Churrosoft/OpenEFI-PCB_next/mainboard_uEFI/mainboard_uEFI.kicad_pcb

## KiCad design mainboard_uEFI/mainboard_uEFI.kicad_pcb (2023-02-02)

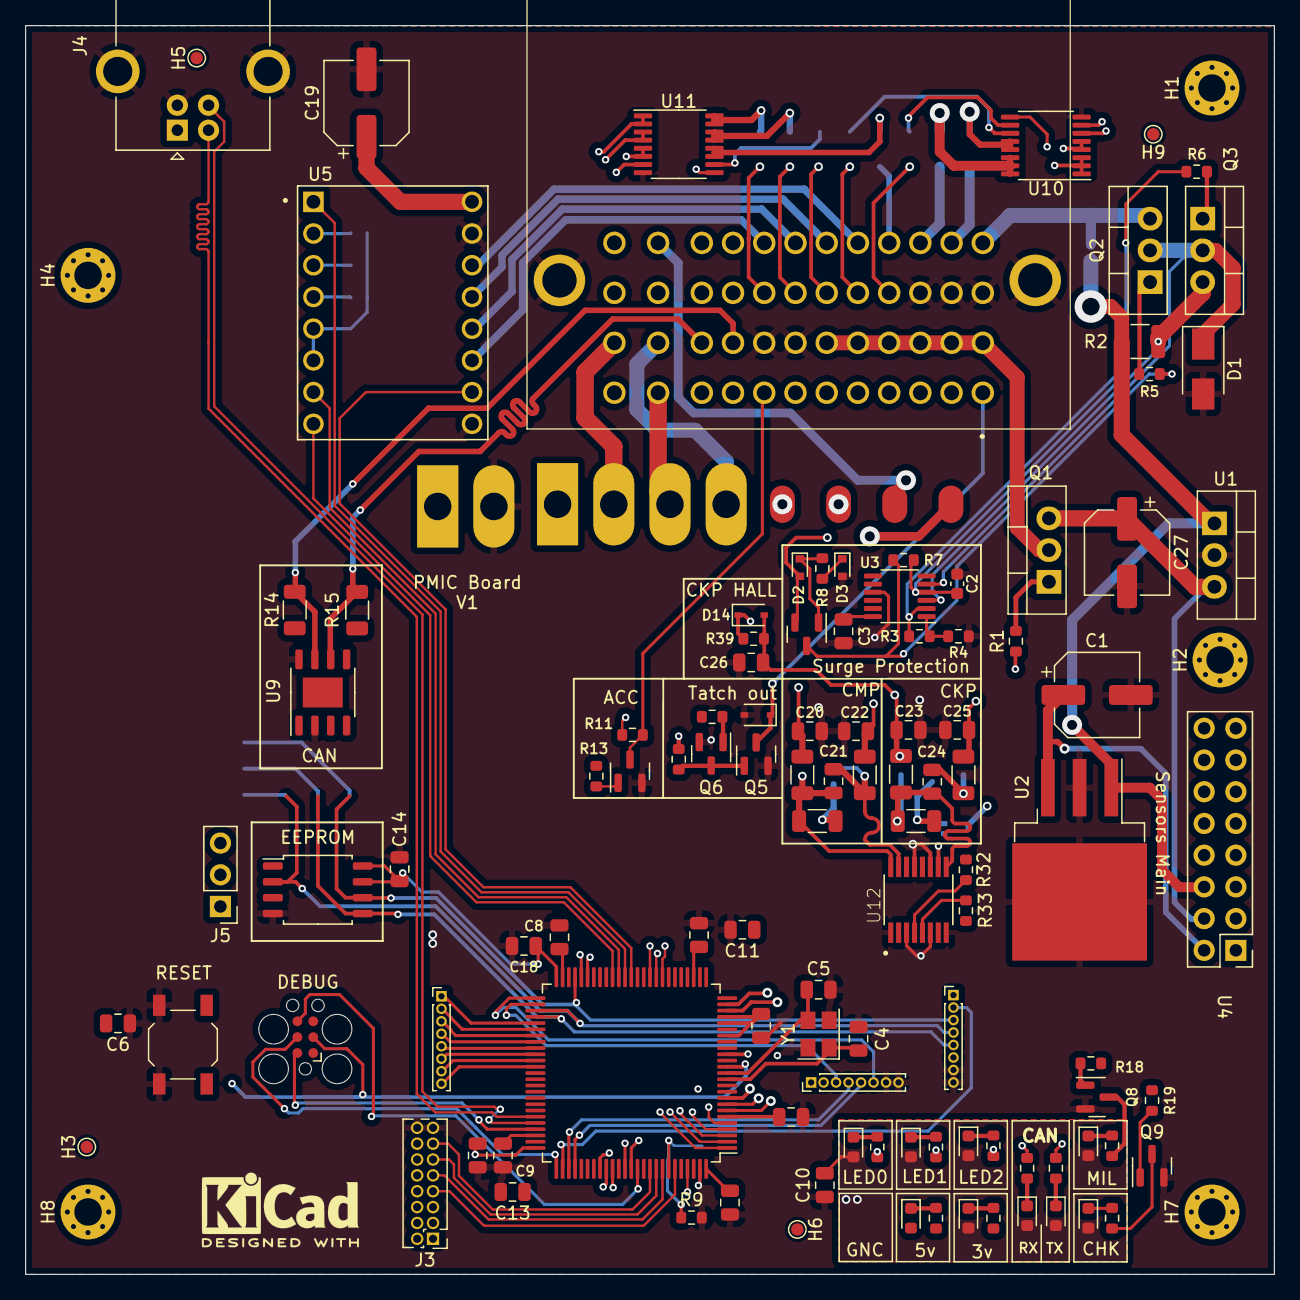
[picture p1: board mainboard_uEFI.kicad_pcb from above]

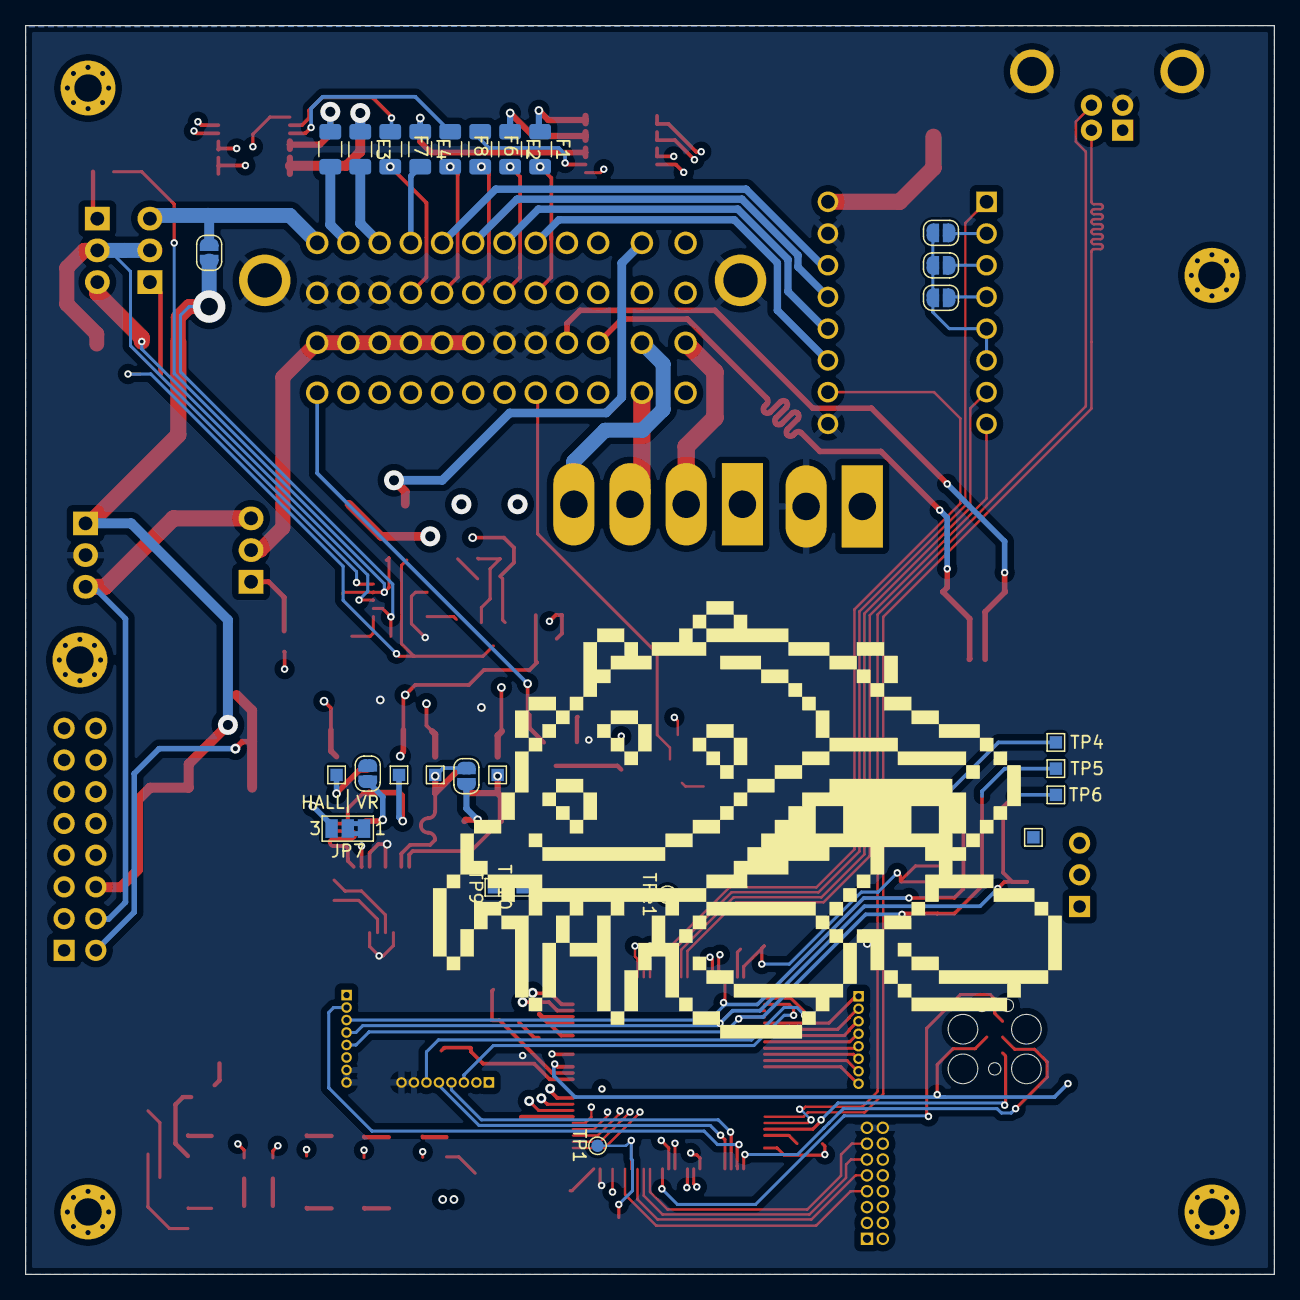
[picture p2: board mainboard_uEFI.kicad_pcb from below]

Board: 4 copper layers, 100.0 x 100.0 mm, 141 parts (27 on the bottom side), 143 nets.

Parts:
C1, C19, C27: 100uF ±20% 35V; CP_Elec_6.3x7.7
C2: 47nF; C_0603_1608Metric
C3, C6, C7, C10, C12, C13, C14, C15, C16, C17: 100nF; C_0805_2012Metric
C4, C5: 15pF; C_0805_2012Metric
C8, C9: 2.2uF; C_0805_2012Metric
C11: 1uF; C_0805_2012Metric
C18: 4.7uF; C_0805_2012Metric
C20, C21, C22, C23, C24, C25, C26: 0.01uF; C_0805_2012Metric
D1: SMAJ58CA; D_SMA
D2, D3: 1N4148; D_SOD-523
D4: MM3Z24VT1G; D_SOD-323
D5, D6, D7, D8, D9, D10, D11, D12, D13: LED; LED_0603_1608Metric
D14: K26; D_SOD-323
F1, F2, F3, F4, F5, F6, F7, F8: 750mA; Fuse_1206_3216Metric
H1, H2, H4, H7, H8: MountingHole; MountingHole_2.2mm_M2_Pad_Via
H3, H5, H6, H9: MountingHole; TestPoint_Pad_D1.0mm
J1: 36638-0002; 366380002
J2: Tag connect; Tag-Connect_TC2030-IDC-FP_2x03_P1.27mm_Vertical
J3: Conn_02x08_Odd_Even; PinHeader_2x08_P1.27mm_Vertical
J4: USB_B; USB_B_OST_USB-B1HSxx_Horizontal
J5: Conn_01x03; PinHeader_1x03_P2.54mm_Vertical
JP1: Jumper_NO_Small; SolderJumper-2_P1.3mm_Open_RoundedPad1.0x1.5mm
JP2, JP3, JP4, JP5, JP6: SolderJumper_2_Open; SolderJumper-2_P1.3mm_Open_RoundedPad1.0x1.5mm
JP7: vr/hall; SolderJumper-3_P1.3mm_Bridged2Bar12_Pad1.0x1.5mm_NumberLabe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
Q1: IRF540N; TO-220-3_Vertical
Q2, Q3: IRLZ44N; TO-220-3_Vertical
Q4, Q6, Q8, Q9: SS8050; SOT-23
Q5, Q7: AO3400A; SOT-23
R1, R5, R6: 10R 1/10W; R_0603_1608Metric
R2: 0.01R; R_1210_3225Metric
R3: 57.6K 1/10W; R_0603_1608Metric
R4: 4.99K 1/10W; R_0603_1608Metric
R7: 1M 1/10W; R_0603_1608Metric
R8: 10K 1/10W; R_0603_1608Metric
R9, R11, R13, R32, R33, R39: 10k; R_0603_1608Metric
R10: 100k; R_0603_1608Metric
R12, R18, R19: 1k; R_0603_1608Metric
R14, R15: 120R; R_1206_3216Metric
R16, R17, R20, R21, R22, R23, R24, R25, R26: 4.7k; R_0603_1608Metric
R27, R30, R34, R37: 10K 1/2W; R_1206_3216Metric
R29, R36: 4.99K 1/2W; R_1206_3216Metric
SW1: SW_Push; SW_SPST_TL3342
SYM1: SYM_Hot_Small; KiCad-Logo2_5mm_SilkScreen
TP1: BOOT0; TestPoint_Pad_D1.0mm
TP2, TP4, TP5, TP6, TP7, TP8, TP9, TP10, TP11, TP12: TestPoint; TestPoint_Pad_1.0x1.0mm
TPe1: BOOT1; TestPoint_Pad_D1.0mm
U1: MIC2940A-5.0WT; TO-220-3_Vertical
U2: MIC2940A-3.3WU; TO-263-3_TabPin2
U3: LT4363IMS; MSOP-12_3x4mm_P0.65mm
U4: SensorsV1
U5: PaP_Driver_v1; IC_DRV8825_STEPPER_MOTOR_DRIVER_CARRIER
U6: 25LCxxx; SOIC-8_5.275x5.275mm_P1.27mm
U7: PMIC_V1; pmic_v1
U8: STM32F407VGTx; LQFP-100_14x14mm_P0.5mm
U9: TJA1042T3118; HTSOP-8-1EP_3.9x4.9mm_P1.27mm_EP2.4x3.2mm
U10, U11: TPL7407LAPWR; TSSOP-16_4.4x5mm_P0.65mm
U12: MAX9926UAEE+; SOP63P602X175-16N
Y1: 25MHz; Crystal_SMD_3225-4Pin_3.2x2.5mm

Connections:
5V_ENABLE: R1.1, U8.16 (PC1)
+3V3: C1.1, C7.1, C10.1, C11.1, C12.1, C13.1, C14.1, C15.1, C16.1, C17.1, C18.1, D5.2 (A), D6.2 (A), D8.2 (A), D9.2 (A), D10.2 (A), D11.2 (A), D12.2 (A), D13.2 (A), D14.1 (K), J2.1, J3.1, JP2.1 (A), JP3.1 (A), JP4.1 (A), R11.1, R32.1, R33.1, R39.1, U2.3 (OUT), U5.5 (RESET), U5.6 (SLEEP), U6.3 (~WP), U6.7 (~HOLD), U6.8 (VCC), U7.34 (3v3), U8.6 (VBAT), U8.11 (VDD), U8.19 (VDD), U8.21 (VREF+), U8.22 (VDDA), U8.28 (VDD), U8.50 (VDD), U8.75 (VDD), U8.100 (VDD), U9.5 (VIO)
+5V: C27.1, D7.2 (A), J3.2, Q1.3 (S), U1.3 (OUT), U9.3 (VCC), U12.14 (VCC)
+5VA: J1.A2, J1.B2, J1.C2, J1.D2, J1.E2, J1.F2, Q1.2 (D)
+12V: C19.1, JP1.2, R2.1, R3.1, R10.1, U1.1 (IN), U2.1 (IN), U3.2 (OUT), U5.16 (VMOT), U7.1 (12v), U7.19 (12v), U7.20 (12v), U10.9 (COM), U11.9 (COM)
+12VA: D2.2 (A), J1.A4, JP1.1, Q2.3 (S), Q4.2 (E)
/ACC_DET: R13.1, U8.80 (PC12)
/AUX_CS_1: J3.3, U8.45 (PE14)
/AUX_CS_2: J3.5, U8.46 (PE15)
/AUX_IN_1: J3.7, U8.95 (PB8)
/AUX_IN_2: J3.9, U8.93 (PB7)
/AUX_IN_3: J3.11, U8.92 (PB6)
/AUX_IN_4: J3.13, U8.91 (PB5)
/AUX_OUT_1: J3.10, U8.35 (PB0)
/AUX_OUT_2: J3.12, U8.34 (PC5)
/AUX_OUT_3: J3.14, U8.33 (PC4)
/CAN1_RX: U8.81 (PD0), U9.4 (RXD)
/CAN1_TX: U8.82 (PD1), U9.1 (TXD)
/CHK: Q9.3 (C), R17.2
/CHK_OUT: R19.1, U8.66 (PC9)
/CKP_D: JP7.2 (C), U8.63 (PC6)
/CKP_VR: JP7.1 (A), R32.2, TP9.1, U12.4 (COUT1)
/CMP: R33.2, TP10.1, U8.64 (PC7), U12.5 (COUT2)
/ECN1: U7.15 (0_c), U8.59 (PD12)
/ECN2: U7.16 (1_c), U8.60 (PD13)
/ECN3: U7.17 (2_c), U8.61 (PD14)
/ECN4: U7.18 (3_c), U8.62 (PD15)
/IN1_N: C21.2, JP5.1 (A), R30.2, TP8.1, U12.15 (IN1-)
/IN1_P: C21.1, R27.2, R29.1, TP7.1, U12.16 (IN1+)
/IN2+: C24.1, R34.2, R36.1, TP11.1, U12.9 (IN2+)
/IN2-: C24.2, JP6.1 (A), R37.2, TP12.1, U12.10 (IN2-)
/INY1: U7.11 (0_c), U8.55 (PD8)
/INY2: U7.12 (1_c), U8.56 (PD9)
/INY3: U7.13 (2_c), U8.57 (PD10)
/INY4: U7.14 (3_c), U8.58 (PD11)
/LED0: R22.2, U8.83 (PD2)
/LED1: R23.2, U8.84 (PD3)
/LED2: R24.2, U8.85 (PD4)
/LED_CAN_RX: R26.2, U8.87 (PD6)
/LED_CAN_TX: R25.2, U8.88 (PD7)
/MEMORY_CS: TP2.1, U6.1 (~CS), U8.44 (PE13)
/MIL: Q8.3 (C), R16.2
/MIL_OUT: R18.1, U8.65 (PC8), U10.7 (IN7)
/MTR_DIR: U5.8 (DIR), U8.41 (PE10)
/MTR_ENABLE: U5.1 (ENABLE), U8.39 (PE8)
/MTR_FAULT: U5.10 (FAULT), U8.38 (PE7)
/MTR_STEP: U5.7 (STEP), U8.40 (PE9)
/NRST: C6.2, J2.3, SW1.1, U8.14 (NRST)
/PMIC_CS: U7.33 (SPI_CS), U8.77 (PA15)
/PMIC_ENABLE: U7.24 (ENABLE), U8.51 (PB12)
/PMIC_MAXI: U7.23 (MAXI), U8.79 (PC11)
/PMIC_NOMI: U7.22 (NOMI), U8.78 (PC10)
/PMIC_SPARK: U7.21 (SPARK), U8.52 (PB13)
/PWM | Relays /CHECK_ENGINE: F8.1, U10.11 (OUT6)
/PWM | Relays /MIL_OUT: F7.1, U10.10 (OUT7)
/PWM | Relays /R3_OUT: F6.1, U11.10 (OUT7)
/RPM_OUT: R12.1, U8.42 (PE11)
/R_AAC: U8.3 (PE4), U11.1 (IN1), U11.2 (IN2)
/R_ECN_INY: U8.1 (PE2), U11.5 (IN5), U11.6 (IN6)
/R_GNC_GLP: U8.2 (PE3), U11.3 (IN3), U11.4 (IN4)
/R_LMB: U8.97 (PE0), U11.7 (IN7)
/SPI2_MISO: J3.6, J5.3, TP6.1, U6.2 (MISO), U7.31 (SPI_MISO), U8.53 (PB14)
/SPI2_MOSI: J3.8, J5.2, TP5.1, U6.5 (MOSI), U7.30 (SPI_MOSI), U8.54 (PB15)
/SPI2_SCK: J3.4, J5.1, TP4.1, U6.6 (SCK), U7.32 (SPI_CLK), U8.47 (PB10)
/SYS_SWCLK: J2.4, U8.76 (PA14)
/SYS_SWDIO: J2.2, U8.72 (PA13)
/SYS_SWO: J2.6, U8.89 (PB3)
/TIM9_CH1: U8.4 (PE5), U10.1 (IN1), U10.2 (IN2), U10.3 (IN3)
/TIM9_CH2: U8.5 (PE6), U10.4 (IN4), U10.5 (IN5)
/USB_D+: J4.3 (D+), U8.71 (PA12)
/USB_D-: J4.2 (D-), U8.70 (PA11)
/VBUS: J4.1 (VBUS), U8.68 (PA9)
A1: D4.1 (K), J1.A1, Q5.3 (D)
B4: F5.2, J1.B4
C4: F3.2, J1.C4
CAN+: J1.J2, R14.2, U9.7 (CANH)
CAN-: J1.K2, R15.2, U9.6 (CANL)
CKP+: C23.1, C26.1, D14.2 (A), J1.K4, JP7.3 (B), R34.1, R39.2
CKP-: C25.1, J1.J4, R37.1
CMP+: C20.1, J1.K3, R27.1
CMP-: C22.1, J1.J3, R30.1
D3: F7.2, J1.D3
D4: F4.2, J1.D4
E3: F8.2, J1.E3
E4: J1.E4, U5.14 (B2)
F3: F6.2, J1.F3
F4: J1.F4, U5.13 (B1)
G3: F2.2, J1.G3
G4: J1.G4, U5.12 (A1)
GND: C1.2, C2.2, C3.2, C4.2, C5.2, C6.1, C7.2, C8.2, C9.2, C10.2, C11.2, C12.2, C13.2, C14.2, C15.2, C16.2, C17.2, C18.2, C19.2, C20.2, C22.2, C23.2, C25.2, C26.2, C27.2, D1.2 (A2), D3.2 (A), D4.2 (A), J1.A3, J1.B3, J1.C3, J1.G2, J1.H2, J1.MH1, J1.MH2, J2.5, J3.15, J3.16, J4.4 (GND), J4.5 (Shield), Q5.2 (S), Q6.2 (E), Q7.2 (S), Q8.2 (E), Q9.2 (E), R4.1, R9.2, R20.2, R21.2, SW1.2, U1.2 (GND), U2.2 (GND), U3.9 (GND), U5.9 (GND), U5.15 (GND), U6.4 (GND), U7.2 (GND), U7.25 (GND), U7.26 (GND), U7.27 (GND), U7.28 (GND), U8.10 (VSS), U8.20 (VSSA), U8.27 (VSS), U8.74 (VSS), U8.99 (VSS), U9.2 (GND), U9.8 (STB), U10.8 (GND), U11.8 (GND), U12.1 (INT_THRS1), U12.3 (BIAS1), U12.6 (BIAS2), U12.8 (INT_THRS2), U12.11 (GND), U12.13 (ZERO_EN), Y1.2, Y1.4
H1: J1.H1, Q7.3 (D), R11.2
H3: F1.2, J1.H3
H4: J1.H4, U5.11 (A2)
L1: J1.L1, U7.5 (2)
L2: J1.L2, U7.6 (3)
L3: J1.L3, U7.10 (3)
L4: J1.L4, U7.9 (2)
M1: J1.M1, U7.3 (0)
M2: J1.M2, U7.4 (1)
M3: J1.M3, U7.8 (1)
M4: J1.M4, U7.7 (0)
unnamed: C2.1, R6.2, R7.1, U3.4 (GATE)
unnamed: C3.1, U3.12 (TMR)
unnamed: C8.1, U8.49 (VCAP_1)
unnamed: C9.1, U8.73 (VCAP_2)
unnamed: D1.1 (A1), Q2.2 (D), Q3.2 (D), U3.5 (VCC)
unnamed: D2.1 (K), Q4.1 (B), R8.1
unnamed: D3.1 (K), R8.2
unnamed: D5.1 (K), R16.1
unnamed: D6.1 (K), R17.1
unnamed: D7.1 (K), R20.1
unnamed: D8.1 (K), R21.1
unnamed: D9.1 (K), R22.1
unnamed: D10.1 (K), R23.1
unnamed: D11.1 (K), R24.1
unnamed: D12.1 (K), R25.1
unnamed: D13.1 (K), R26.1
unnamed: F1.1, U11.15 (OUT2), U11.16 (OUT1)
unnamed: F2.1, U11.13 (OUT4), U11.14 (OUT3)
unnamed: F3.1, U10.14 (OUT3), U10.15 (OUT2), U10.16 (OUT1)
unnamed: F4.1, U11.11 (OUT6), U11.12 (OUT5)
unnamed: F5.1, U10.12 (OUT5), U10.13 (OUT4)
unnamed: JP2.2 (B), U5.2 (M0)
unnamed: JP3.2 (B), U5.3 (M1)
unnamed: JP4.2 (B), U5.4 (M2)
unnamed: JP5.2 (B), R29.2
unnamed: JP6.2 (B), R36.2
unnamed: Q1.1 (G), R1.2
unnamed: Q2.1 (G), R5.1
unnamed: Q3.1 (G), R6.1
unnamed: Q3.3 (S), R2.2, U3.3 (SNS)
unnamed: Q4.3 (C), R5.2, R7.2
unnamed: Q5.1 (G), Q6.3 (C), R10.2
unnamed: Q6.1 (B), R12.2
unnamed: Q7.1 (G), R13.2
unnamed: Q8.1 (B), R18.2
unnamed: Q9.1 (B), R19.2
unnamed: R3.2, R4.2, U3.1 (FB)
unnamed: R9.1, TP1.1, U8.94 (BOOT0)
unnamed: R14.1, R15.1
unnamed: TPe1.1, U8.37 (PB2)
OSC_IN: C4.1, U8.12 (PH0), Y1.1
OSC_OUT: C5.1, U8.13 (PH1), Y1.3
