Churrosoft/OpenEFI-PCB_next/pmic/MC33810_v1/MC33810_v1.kicad_pcb

## KiCad design pmic/MC33810_v1/MC33810_v1.kicad_pcb (2023-01-31)

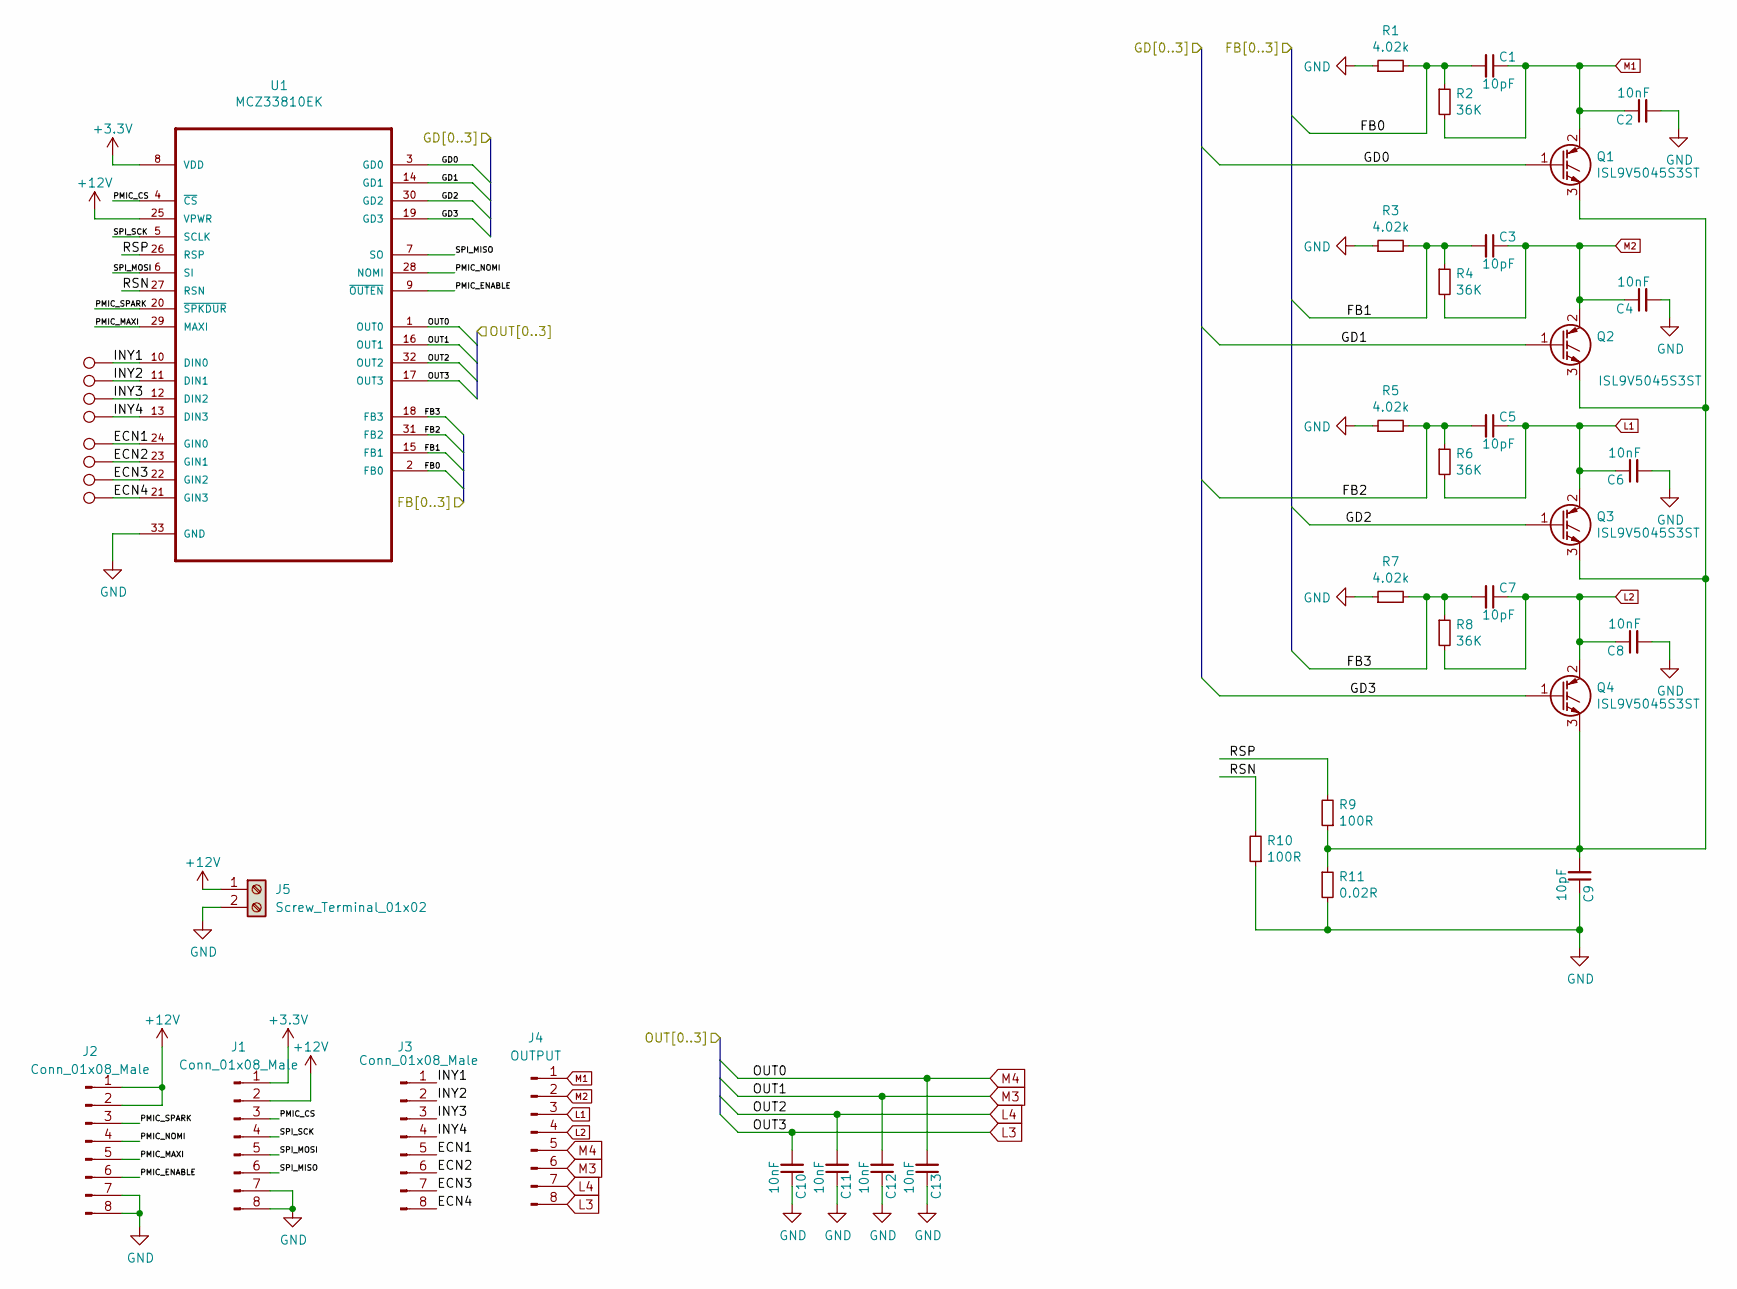
[picture p3: schematic MC33810_v1.kicad_sch]

Parts:
C1, C3, C5, C7: 10pF; C_0603_1608Metric; LCSC C106245
C2, C4, C6, C8, C10, C11, C12, C13: 10nF; C_0603_1608Metric; LCSC C100042
C9: 10pF; C_0603_1608Metric
J1, J2, J3: Conn_01x08_Male; PinHeader_1x08_P1.00mm_Vertical
J4: OUTPUT; TerminalBlock_Dinkle_DT-55-B01X-08_P10.00mm
J5: Screw_Terminal_01x02; TerminalBlock_Dinkle_DT-55-B01X-02_P10.00mm
Q1, Q2, Q3, Q4: ISL9V5045S3ST; TO-263-2
R1, R3, R5, R7: 4.02k; R_0603_1608Metric; LCSC C23040
R2, R4, R6, R8: 36K; R_0603_1608Metric; LCSC C192548
R9, R10: 100R; R_0603_1608Metric; LCSC C159890
R11: 0.02R; R_2512_6332Metric; LCSC C326611
TP1, TP2, TP3, TP4, TP5, TP6, TP7, TP8: TestPoint; TestPoint_Pad_1.0x1.0mm
U1: MCZ33810EK; SOP65P1030X245-33N

Connections:
+3V3: J1.1, U1.8 (VDD)
+12V: J1.2, J2.1, J2.2, J5.1, U1.25 (VPWR)
/ECN1: J3.5, TP5.1, U1.24 (GIN0)
/ECN2: J3.6, TP6.1, U1.23 (GIN1)
/ECN3: J3.7, TP7.1, U1.22 (GIN2)
/ECN4: J3.8, TP8.1, U1.21 (GIN3)
/FB0: C1.2, R1.2, R2.1, U1.2 (FB0)
/FB1: C3.2, R3.2, R4.1, U1.15 (FB1)
/FB2: C5.2, R5.2, R6.1, U1.31 (FB2)
/FB3: C7.2, R7.2, R8.1, U1.18 (FB3)
/GD0: Q1.1 (G), U1.3 (GD0)
/GD1: Q2.1 (G), U1.14 (GD1)
/GD2: Q3.1 (G), U1.30 (GD2)
/GD3: Q4.1 (G), U1.19 (GD3)
/INY1: J3.1, TP1.1, U1.10 (DIN0)
/INY2: J3.2, TP2.1, U1.11 (DIN1)
/INY3: J3.3, TP3.1, U1.12 (DIN2)
/INY4: J3.4, TP4.1, U1.13 (DIN3)
/PMIC_CS: J1.3, U1.4 (~CS)
/PMIC_ENABLE: J2.6, U1.9 (~OUTEN)
/PMIC_MAXI: J2.5, U1.29 (MAXI)
/PMIC_NOMI: J2.4, U1.28 (NOMI)
/PMIC_SPARK: J2.3, U1.20 (~SPKDUR)
/RSN: R10.2, U1.27 (RSN)
/RSP: R9.2, U1.26 (RSP)
/SPI_MISO: J1.6, U1.7 (SO)
/SPI_MOSI: J1.5, U1.6 (SI)
/SPI_SCK: J1.4, U1.5 (SCLK)
GND: C2.2, C4.2, C6.2, C8.2, C9.1, C10.1, C11.1, C12.1, C13.1, J1.7, J1.8, J2.7, J2.8, J5.2, R1.1, R3.1, R5.1, R7.1, R10.1, R11.2, U1.33 (GND)
L1: C5.1, C6.1, J4.3, Q3.2 (C), R6.2
L2: C7.1, C8.1, J4.4, Q4.2 (C), R8.2
L3: C10.2, J4.8, U1.17 (OUT3)
L4: C11.2, J4.7, U1.32 (OUT2)
M1: C1.1, C2.1, J4.1, Q1.2 (C), R2.2
M2: C3.1, C4.1, J4.2, Q2.2 (C), R4.2
M3: C12.2, J4.6, U1.16 (OUT1)
M4: C13.2, J4.5, U1.1 (OUT0)
unnamed: C9.2, Q1.3 (E), Q2.3 (E), Q3.3 (E), Q4.3 (E), R9.1, R11.1

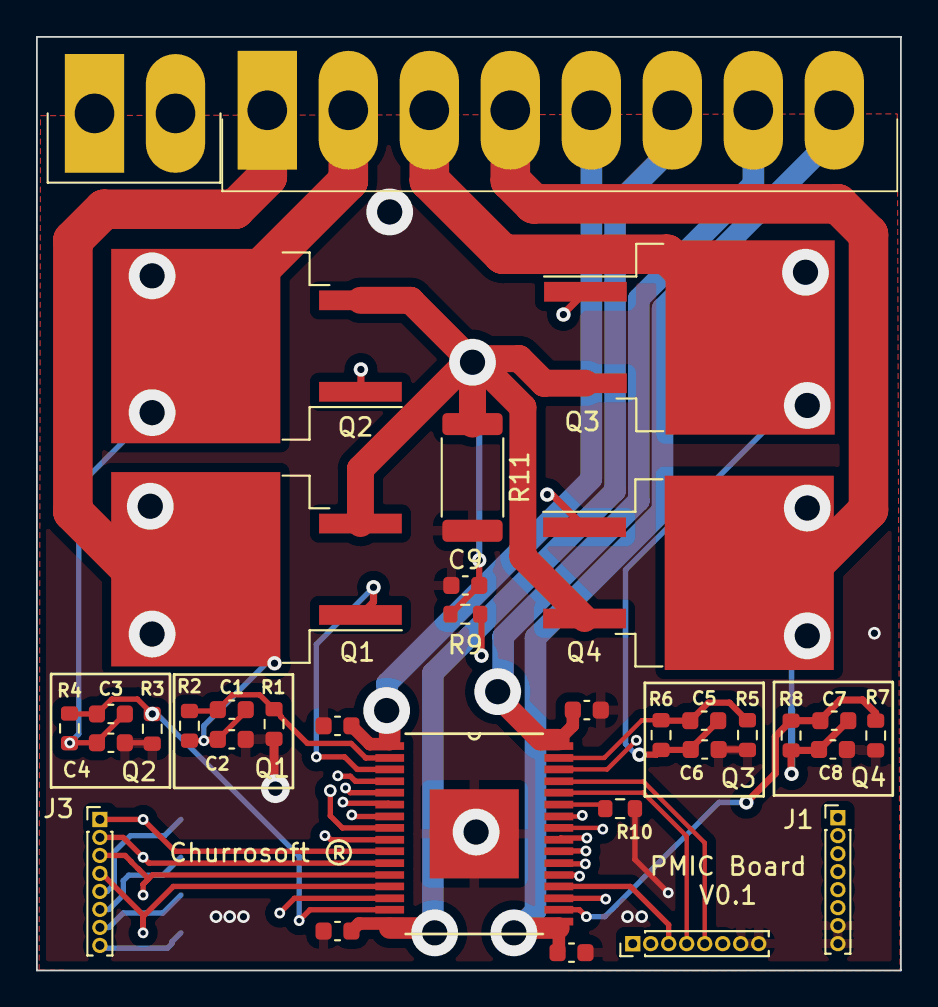
[picture p4: board MC33810_v1.kicad_pcb from above]

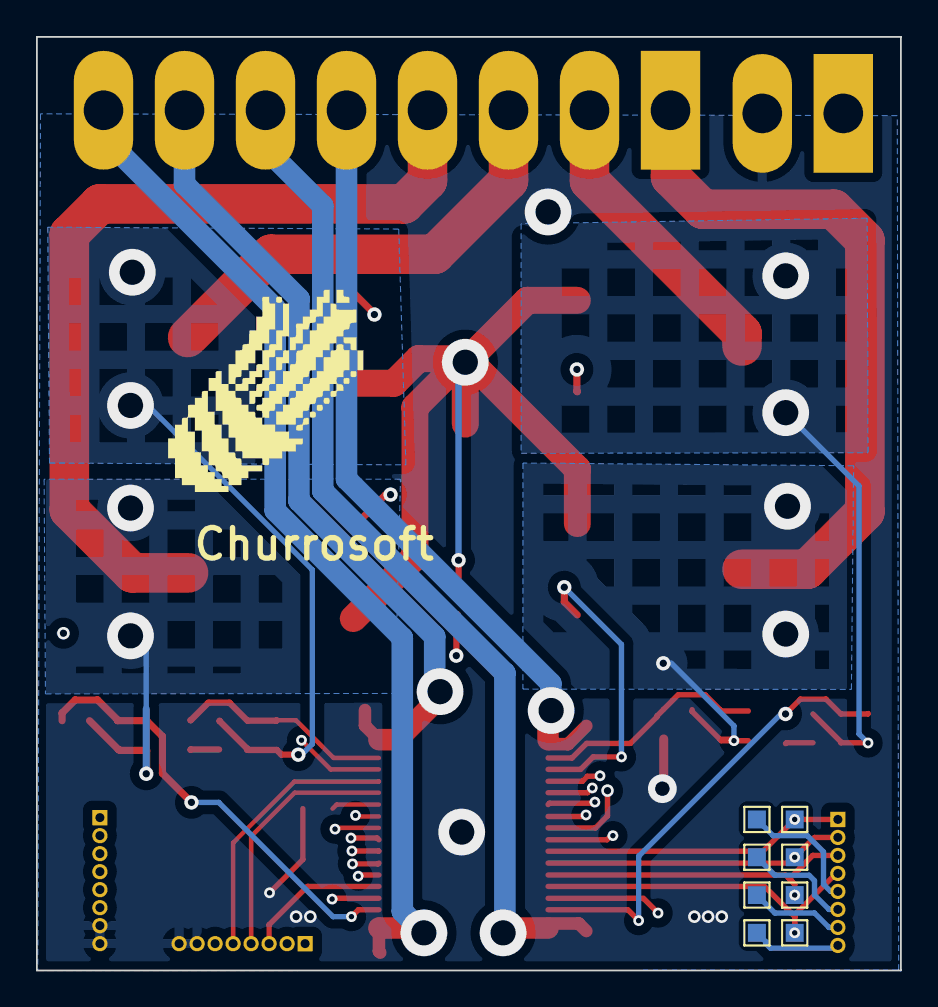
[picture p5: board MC33810_v1.kicad_pcb from below]

Board: 4 copper layers, 48.0 x 51.9 mm, 43 parts (9 on the bottom side), 38 nets.

Other parts of the board:
Churrosoft: SYM_Hot_Large; churro_new_v4
