Churrosoft/OpenEFI-PCB_next/pmic/basic_v1/basic_v1.kicad_pcb

## KiCad design pmic/basic_v1/basic_v1.kicad_pcb (2023-01-31)

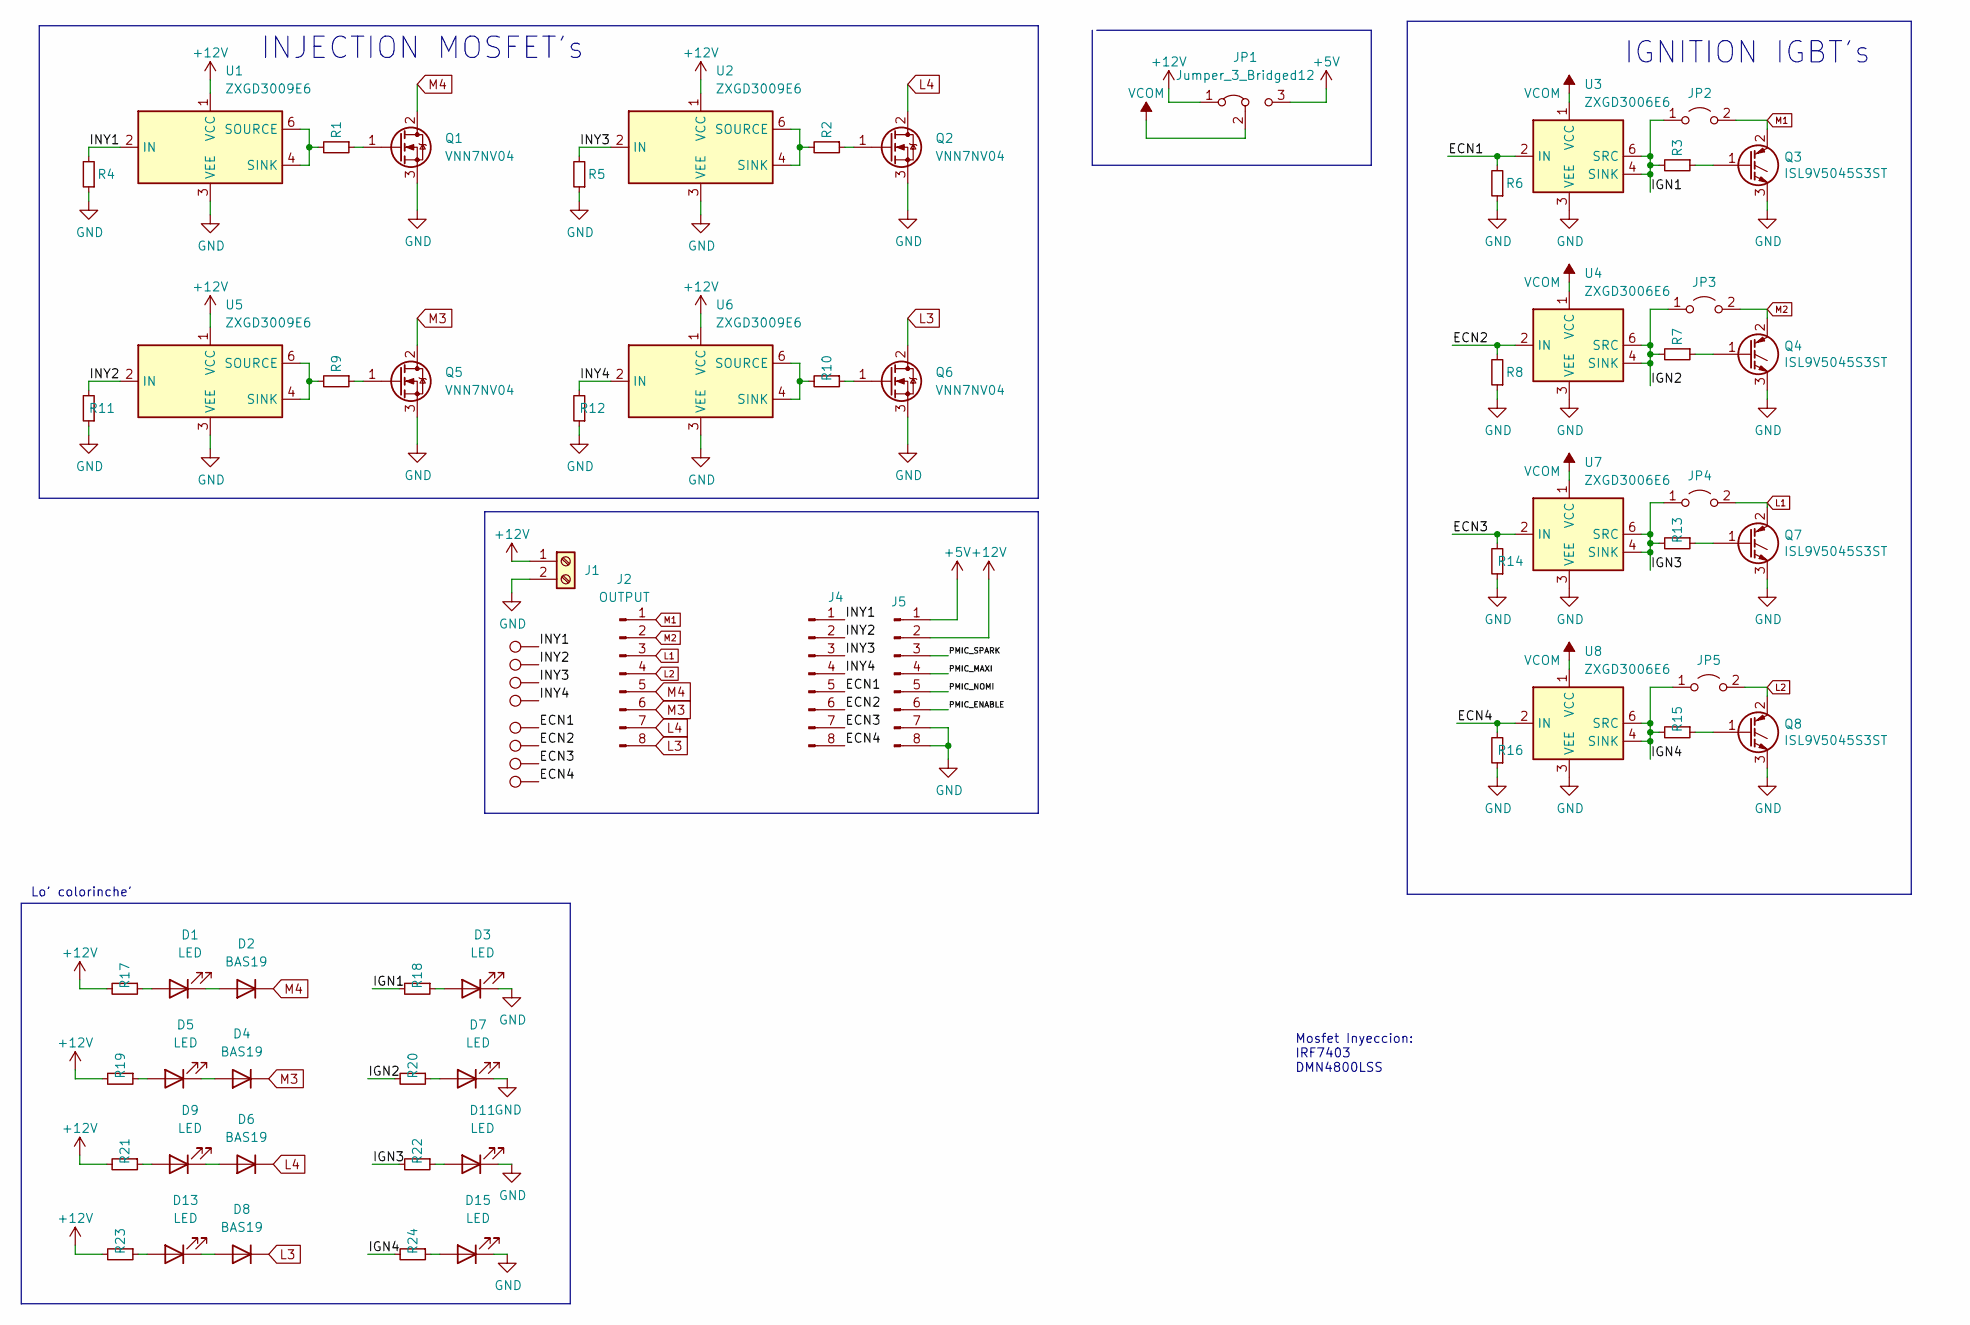
[picture p6: schematic basic_v1.kicad_sch]

Parts:
D1, D3, D5, D7, D9, D11, D13, D15: LED; LED_0603_1608Metric
D2, D4, D6, D8: BAS19; SOT-23; LCSC C8661
J1: Screw_Terminal_01x02; TerminalBlock_Dinkle_DT-55-B01X-02_P10.00mm
J2: OUTPUT; hipower_8pin
J4, J5: Conn_01x08_Male; PinHeader_1x08_P1.00mm_Vertical
JP1: Jumper_3_Bridged12; PinHeader_1x03_P2.54mm_Vertical
JP2, JP3, JP4, JP5: Jumper_2_Open; SolderJumper-2_P1.3mm_Open_RoundedPad1.0x1.5mm
Q1, Q2, Q5, Q6: VNN7NV04; TO-252-2; LCSC C155605
Q3, Q4, Q7, Q8: ISL9V5045S3ST; TO-263-2
R1, R2, R3, R7, R9, R10, R13, R15: 22R; R_0805_2012Metric
R4, R5, R6, R8, R11, R12, R14, R16: 100k 1/10W +-1%; R_0603_1608Metric; LCSC C217840
R17, R18, R19, R20, R21, R22, R23, R24: 680R; R_0603_1608Metric; LCSC C217840
TP1, TP2, TP3, TP4, TP5, TP6, TP7, TP8: TestPoint; TestPoint_Pad_1.0x1.0mm
U1, U2, U5, U6: ZXGD3009E6; SOT-23-6
U3, U4, U7, U8: ZXGD3006E6; SOT-23-6

Connections:
+5V: J5.1, JP1.3 (B)
+12V: J1.1, J5.2, JP1.1 (A), R17.2, R19.2, R21.2, R23.2, U1.1 (VCC), U2.1 (VCC), U5.1 (VCC), U6.1 (VCC)
/ECN1: J4.5, R6.2, TP5.1, U3.2 (IN)
/ECN2: J4.6, R8.2, TP6.1, U4.2 (IN)
/ECN3: J4.7, R14.2, TP7.1, U7.2 (IN)
/ECN4: J4.8, R16.2, TP8.1, U8.2 (IN)
/IGN1: JP2.1 (A), R3.2, R18.2, U3.4 (SINK), U3.6 (SRC)
/IGN2: JP3.1 (A), R7.2, R20.2, U4.4 (SINK), U4.6 (SRC)
/IGN3: JP4.1 (A), R13.2, R22.2, U7.4 (SINK), U7.6 (SRC)
/IGN4: JP5.1 (A), R15.2, R24.2, U8.4 (SINK), U8.6 (SRC)
/INY1: J4.1, R4.2, TP1.1, U1.2 (IN)
/INY2: J4.2, R11.2, TP2.1, U5.2 (IN)
/INY3: J4.3, R5.2, TP3.1, U2.2 (IN)
/INY4: J4.4, R12.2, TP4.1, U6.2 (IN)
/PMIC_ENABLE: J5.6
/PMIC_MAXI: J5.4
/PMIC_NOMI: J5.5
/PMIC_SPARK: J5.3
GND: D3.1 (K), D7.1 (K), D11.1 (K), D15.1 (K), J1.2, J5.7, J5.8, Q1.3 (S), Q2.3 (S), Q3.3 (E), Q4.3 (E), Q5.3 (S), Q6.3 (S), Q7.3 (E), Q8.3 (E), R4.1, R5.1, R6.1, R8.1, R11.1, R12.1, R14.1, R16.1, U1.3 (VEE), U2.3 (VEE), U3.3 (VEE), U4.3 (VEE), U5.3 (VEE), U6.3 (VEE), U7.3 (VEE), U8.3 (VEE)
L1: J2.3, JP4.2 (B), Q7.2 (C)
L2: J2.4, JP5.2 (B), Q8.2 (C)
L3: D8.3 (K), J2.8, Q6.2 (D)
L4: D6.3 (K), J2.7, Q2.2 (D)
M1: J2.1, JP2.2 (B), Q3.2 (C)
M2: J2.2, JP3.2 (B), Q4.2 (C)
M3: D4.3 (K), J2.6, Q5.2 (D)
M4: D2.3 (K), J2.5, Q1.2 (D)
unnamed: D1.1 (K), D2.1 (A)
unnamed: D1.2 (A), R17.1
unnamed: D3.2 (A), R18.1
unnamed: D4.1 (A), D5.1 (K)
unnamed: D5.2 (A), R19.1
unnamed: D6.1 (A), D9.1 (K)
unnamed: D7.2 (A), R20.1
unnamed: D9.2 (A), R21.1
unnamed: D11.2 (A), R22.1
unnamed: D8.1 (A), D13.1 (K)
unnamed: D13.2 (A), R23.1
unnamed: D15.2 (A), R24.1
unnamed: Q1.1 (G), R1.1
unnamed: Q2.1 (G), R2.1
unnamed: Q3.1 (G), R3.1
unnamed: Q4.1 (G), R7.1
unnamed: Q5.1 (G), R9.1
unnamed: Q6.1 (G), R10.1
unnamed: Q7.1 (G), R13.1
unnamed: Q8.1 (G), R15.1
unnamed: R1.2, U1.4 (SINK), U1.6 (SOURCE)
unnamed: R2.2, U2.4 (SINK), U2.6 (SOURCE)
unnamed: R9.2, U5.4 (SINK), U5.6 (SOURCE)
unnamed: R10.2, U6.4 (SINK), U6.6 (SOURCE)
VCOM: JP1.2 (C), U3.1 (VCC), U4.1 (VCC), U7.1 (VCC), U8.1 (VCC)

Notes on the sheet:
Lo' colorinche'
IGNITION IGBT's
INJECTION MOSFET's
Mosfet Inyeccion: IRF7403 DMN4800LSS

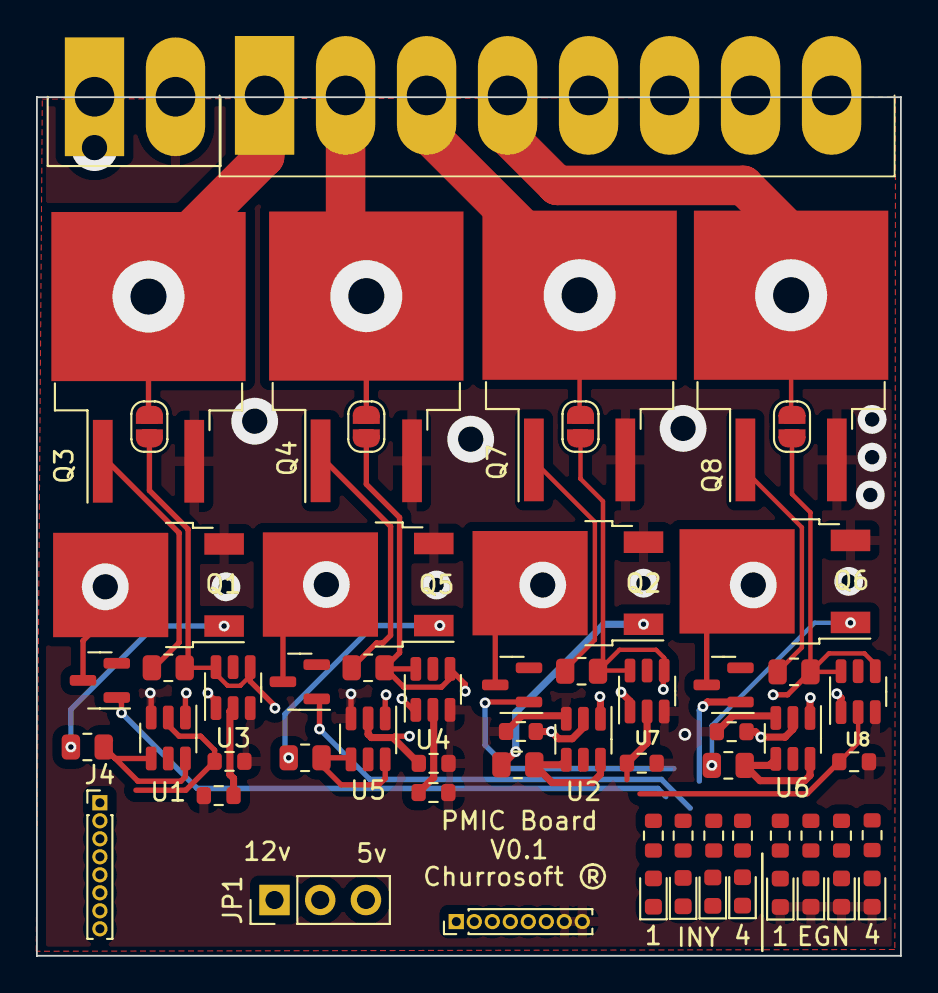
[picture p7: board basic_v1.kicad_pcb from above]

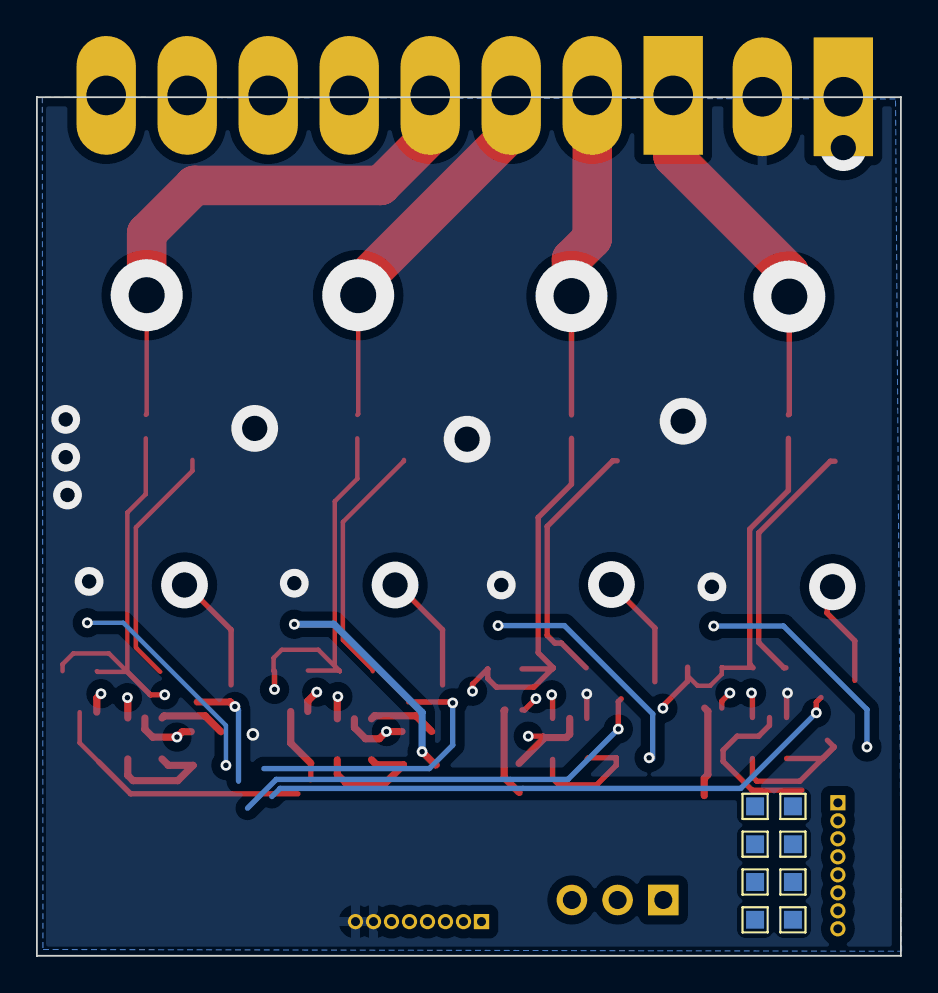
[picture p8: board basic_v1.kicad_pcb from below]

Board: 4 copper layers, 48.0 x 47.7 mm, 69 parts (8 on the bottom side), 48 nets.
