Churrosoft/OpenEFI-PCB_next/sensors/uefi_basic_v1/uefi_basic_v1.kicad_pcb

## KiCad design sensors/uefi_basic_v1/uefi_basic_v1.kicad_pcb (2023-01-31)

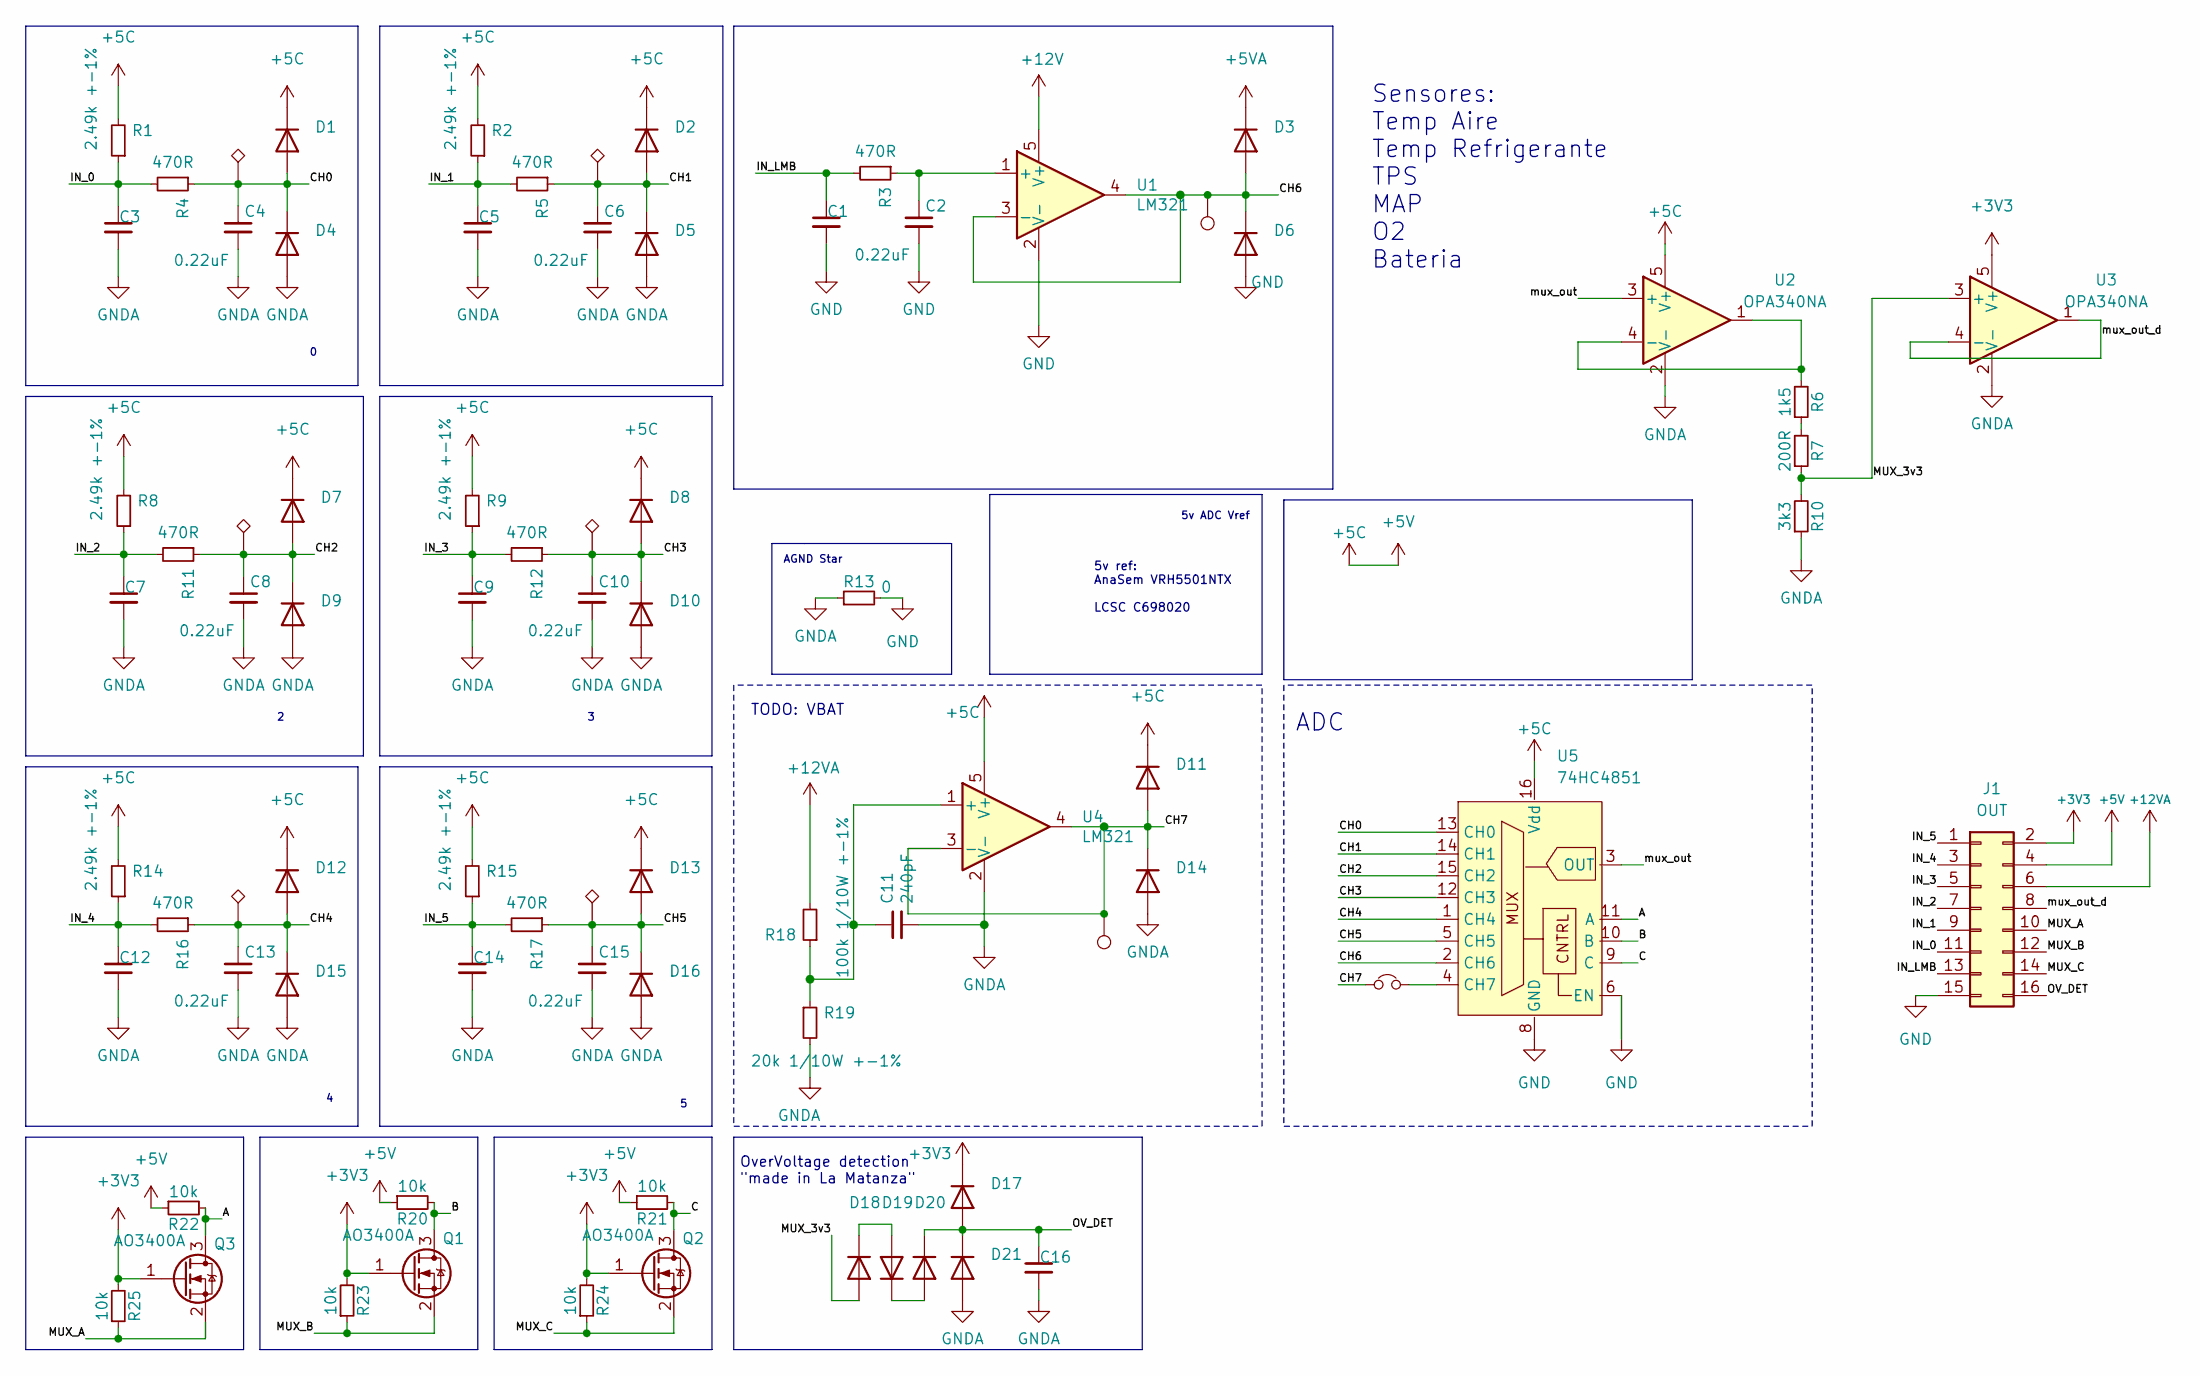
[picture p9: schematic uefi_basic_v1.kicad_sch]

Parts:
C1, C3, C5, C7, C9, C12, C14, C16: 100nF; C_0805_2012Metric; LCSC C49678
C2, C4, C6, C8, C10, C13, C15: 0.22uF; C_0603_1608Metric
C11: 240pF; C_0603_1608Metric; LCSC C185593
D1, D2, D3, D4, D5, D6, D7, D8, D9, D10, D11, D12, D13, D14, D15, D16, D17, D18, D19, D20, D21: K26; D_SOD-323; LCSC C2922179
J1: OUT; PinHeader_2x08_P2.54mm_Vertical
JP1: Jumper_NC_Small; SolderJumper-2_P1.3mm_Open_TrianglePad1.0x1.5mm
Q1, Q2, Q3: AO3400A; SOT-23; LCSC C347475
R1, R2, R8, R9, R14, R15: 2.49k +-1%; R_0603_1608Metric
R3, R4, R5, R11, R12, R16, R17: 470R; R_0603_1608Metric
R6: 1k5; R_0603_1608Metric
R7: 200R; R_0603_1608Metric
R10: 3k3; R_0603_1608Metric
R13: 0; R_0603_1608Metric
R18: 100k 1/10W +-1%; R_0603_1608Metric; LCSC C217840
R19: 20k 1/10W +-1%; R_0603_1608Metric
R20, R21, R22, R23, R24, R25: 10k; R_0603_1608Metric
TP1, TP2, TP4, TP5, TP7, TP8: TestPoint_Alt; TestPoint_THTPad_1.0x1.0mm_Drill0.5mm
TP3, TP6: TestPoint; TestPoint_Pad_2.0x2.0mm
U1, U4: LM321; SOT-23-5
U2, U3: OPA340NA; SOT-23-5
U5: 74HC4851; SOIC-16_3.9x9.9mm_P1.27mm; LCSC C233468

Connections:
+3V3: D17.1 (K), J1.2, Q1.1 (G), Q2.1 (G), Q3.1 (G), R23.2, R24.2, R25.2, U3.5 (V+)
+5C: D1.1 (K), D2.1 (K), D7.1 (K), D8.1 (K), D11.1 (K), D12.1 (K), D13.1 (K), J1.4, R1.2, R2.2, R8.2, R9.2, R14.2, R15.2, R20.1, R21.1, R22.1, U2.5 (V+), U4.5 (V+), U5.16 (Vdd)
+5VA: D3.1 (K)
+12V: U1.5 (V+)
+12VA: J1.6, R18.2
/A: Q3.3 (D), R22.2, U5.11 (A)
/B: Q1.3 (D), R20.2, U5.10 (B)
/C: Q2.3 (D), R21.2, U5.9 (C)
/CH0: C4.1, D1.2 (A), D4.1 (K), R4.1, TP1.1, U5.13 (CH0)
/CH1: C6.1, D2.2 (A), D5.1 (K), R5.1, TP2.1, U5.14 (CH1)
/CH2: C8.1, D7.2 (A), D9.1 (K), R11.1, TP4.1, U5.15 (CH2)
/CH3: C10.1, D8.2 (A), D10.1 (K), R12.1, TP5.1, U5.12 (CH3)
/CH4: C13.1, D12.2 (A), D15.1 (K), R16.1, TP7.1, U5.1 (CH4)
/CH5: C15.1, D13.2 (A), D16.1 (K), R17.1, TP8.1, U5.5 (CH5)
/CH6: D3.2 (A), D6.1 (K), TP3.1, U1.3 (-), U1.4, U5.2 (CH6)
/CH7: D11.2 (A), D14.1 (K), JP1.1, TP6.1, U4.3 (-), U4.4
/IN_0: C3.1, J1.11, R1.1, R4.2
/IN_1: C5.1, J1.9, R2.1, R5.2
/IN_2: C7.1, J1.7, R8.1, R11.2
/IN_3: C9.1, J1.5, R9.1, R12.2
/IN_4: C12.1, J1.3, R14.1, R16.2
/IN_5: C14.1, J1.1, R15.1, R17.2
/IN_LMB: C1.1, J1.13, R3.2
/MUX_3v3: D18.2 (A), R7.1, R10.2, U3.3 (+)
/MUX_A: J1.10, Q3.2 (S), R25.1
/MUX_B: J1.12, Q1.2 (S), R23.1
/MUX_C: J1.14, Q2.2 (S), R24.1
/OV_DET: C16.1, D17.2 (A), D20.1 (K), D21.1 (K), J1.16
/mux_out: U2.3 (+), U5.3 (OUT)
/mux_out_d: J1.8, U3.1, U3.4 (-)
GND: C1.2, C2.2, D6.2 (A), J1.15, R13.2, U1.2 (V-), U5.6 (EN), U5.8 (GND)
GNDA: C3.2, C4.2, C5.2, C6.2, C7.2, C8.2, C9.2, C10.2, C11.2, C12.2, C13.2, C14.2, C15.2, C16.2, D4.2 (A), D5.2 (A), D9.2 (A), D10.2 (A), D14.2 (A), D15.2 (A), D16.2 (A), D21.2 (A), R10.1, R13.1, R19.2, U2.2 (V-), U3.2 (V-), U4.2 (V-)
unnamed: C2.1, R3.1, U1.1 (+)
unnamed: C11.1, R18.1, R19.1, U4.1 (+)
unnamed: D18.1 (K), D19.2 (A)
unnamed: D19.1 (K), D20.2 (A)
unnamed: JP1.2, U5.4 (CH7)
unnamed: R6.1, R7.2
unnamed: R6.2, U2.1, U2.4 (-)

Notes on the sheet:
OverVoltage detection "made in La Matanza"
Sensores: Temp Aire Temp Refrigerante TPS MAP O2 Bateria
5v ADC Vref
AGND Star
5v ref: AnaSem VRH5501NTX LCSC C698020
ADC
TODO: VBAT

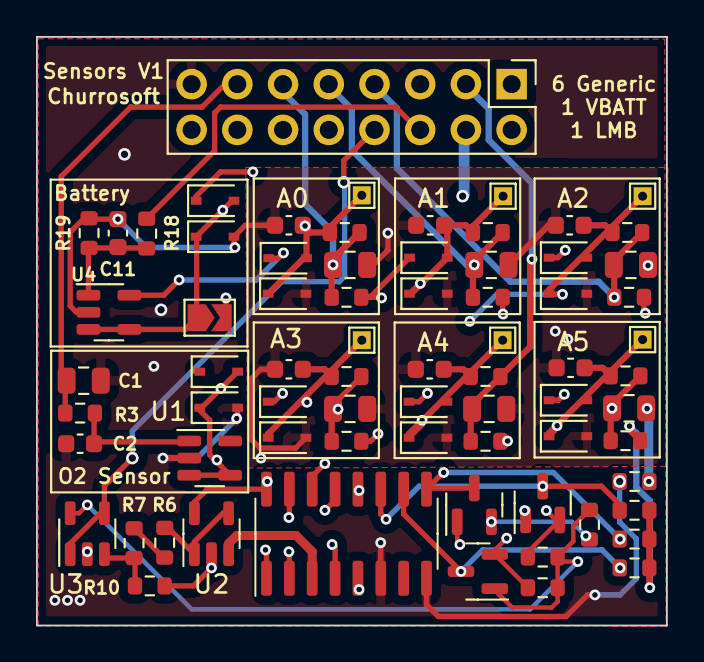
[picture p10: board uefi_basic_v1.kicad_pcb from above]

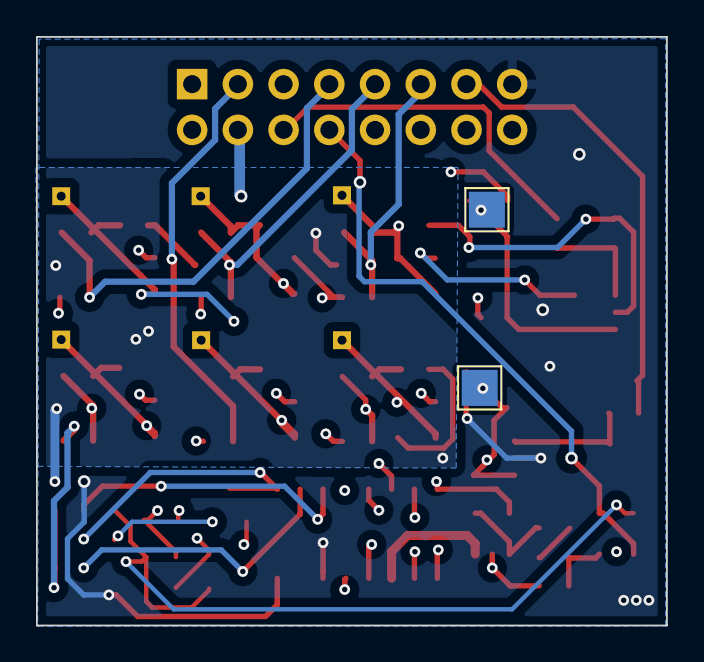
[picture p11: board uefi_basic_v1.kicad_pcb from below]

Board: 4 copper layers, 35.0 x 32.7 mm, 74 parts (2 on the bottom side), 34 nets.
