Churrosoft/OpenEFI-PCB_next/(commit log)

2023-01-16 WIP: pmic module
    [MC33810_v1.kicad_pcb, MC33810_v1.kicad_sch, basic_v1.kicad_pcb, basic_v1.kicad_sch, mainboard_uEFI.kicad_pcb, mainboard_uEFI.kicad_sch]
2023-01-18 basic driver v1
    [basic_v1.kicad_pcb, basic_v1.kicad_sch]
2023-01-31 wip uefi mainboard
    [MC33810_v1.kicad_pcb, MC33810_v1.kicad_sch, basic_v1.kicad_pcb, connector.kicad_sch, mainboard_uEFI.kicad_pcb, relays.kicad_sch, uefi_basic_v1.kicad_pcb, uefi_basic_v1.kicad_sch]
2023-02-01 wip uefi v4 mainboard
    [mainboard_uEFI.kicad_pcb, mainboard_uEFI.kicad_sch]
2023-02-02 wip uefi mainboard, led wiring
    [mainboard_uEFI.kicad_pcb, mainboard_uEFI.kicad_sch]
2023-02-02 uefi v4 mainboard, wip relay
    [mainboard_uEFI.kicad_pcb, mainboard_uEFI.kicad_sch, relays.kicad_sch]
